NBER08/DIY-Startracker/hardware/CAD/README.md

# 3D CAD design
All 3D design for this project were done in Onshape.
[Project link](https://cad.onshape.com/documents/59d2a65c75123b6fec6ec18b/w/6b35aeebfd23d6bcbcd6099d/e/87f6b82d51a6b9adfaf05478)
