NBER08/DIY-Startracker/firmware/Startracker_draft/src/sensors/gps.h

#pragma once
#include <stdbool.h>

// This is everything the rest of the code needs to know about GPS.
// It doesn't need to know HOW we get it — just what we get.

typedef struct {
    double lat;       // e.g. 46.07  (your latitude in degrees)
    double lon;       // e.g. 18.23  (your longitude in degrees)
    long   unix_sec;  // current UTC time as seconds since 1970
    int    satellites;
    bool   valid;     // false until we have a real fix
} GpsFix;

// Call once at startup
void gps_begin();

// Call anytime to get the latest data.
// Returns a GpsFix — check .valid before using it.
GpsFix gps_read();
