NBER08/DIY-Startracker/(commit log)

2026-03-11 Copied KiCAD project into hardware
    [Startracker.kicad_pcb, Startracker.kicad_sch, conn.kicad_sch, lora.kicad_sch, motor_driver.kicad_sch, obc.kicad_sch, ps.kicad_sch, sensors.kicad_sch]
2026-03-11 tested gitignore
    [Startracker.kicad_pcb, Startracker.kicad_sch, conn.kicad_sch, lora.kicad_sch, motor_driver.kicad_sch, obc.kicad_sch, ps.kicad_sch, sensors.kicad_sch]
2026-03-11 Revise README with updated schematic and design rules
    Updated the schematic structure and design rules sections, including new sheets and fabrication details.
2026-03-12 Added connection for external IMU to PCB
    [Startracker.kicad_sch, conn.kicad_sch, sensors.kicad_sch]
2026-03-12 Changed LoRa modul on PCB
    [lora.kicad_sch]
2026-03-12 Added I2C expander for motor drivers and changed LoRa module
    [Startracker.kicad_sch, lora.kicad_sch, motor_driver.kicad_sch, obc.kicad_sch]
2026-03-12 Started RF design for LoRa chip
    [lora.kicad_sch]
2026-03-13 Started shcematic design for LoRa chip
    [lora.kicad_sch]
2026-03-14 Finished schematic for LoRa, added BME280
    [Startracker.kicad_sch, conn.kicad_sch, lora.kicad_sch, motor_driver.kicad_sch, obc.kicad_sch, ps.kicad_sch, sensors.kicad_sch, usb.kicad_sch]
2026-03-14 Finished parts sourcing and added missing footprints
    [conn.kicad_sch, lora.kicad_sch, ps.kicad_sch]
2026-03-14 Rerouted changes on the PCB layout, Routed LoRa
    [Startracker.kicad_pcb, Startracker.kicad_sch, motor_driver.kicad_sch, obc.kicad_sch, sensors.kicad_sch]
2026-03-14 Completed placement of components on PCB
    [Startracker.kicad_pcb, sensors.kicad_sch]
2026-03-14 Finished routing and layout of PCB
    [Startracker.kicad_pcb, obc.kicad_sch, sensors.kicad_sch]
2026-03-16 correctedai code and started customizing
    [gps.cpp, imu.cpp, imu.h, main.cpp, motor.cpp]
2026-03-16 Added remaining sensors to firmware
2026-03-17 made test file for testing esp timer
2026-03-19 Removed on-PCB BNO085 and added VL53L4CD ToF sensor
    [sensors.kicad_sch]
2026-03-19 Routed VL53L4CD
    [Startracker.kicad_pcb, Startracker.kicad_sch, sensors.kicad_sch]
2026-03-19 Removed correction feature from firmware
    [imu.h, lora.cpp, lora.h, main.cpp, motor.cpp, motor.h]
2026-03-19 added external ToF instead of on-PCB
    [Startracker.kicad_pcb, Startracker.kicad_sch, obc.kicad_sch, sensors.kicad_sch]
2026-03-19 Added external QMC5883L instead of on-PCB IIS2MDCTR
    [Startracker.kicad_pcb, sensors.kicad_sch]
2026-03-28 Removed polar azimuth motor driver from pcb
    [Startracker-CuBottom.gbr, Startracker-CuIn1.gbr, Startracker-CuIn2.gbr, Startracker-CuTop.gbr, Startracker-EdgeCuts.gbr, Startracker-MaskBottom.gbr, Startracker-MaskTop.gbr, Startracker-NPTH.drl]
2026-04-02 Reorganized PCB files and made BNO085 breakout
    [Startracker-CuBottom.gbr, Startracker-CuIn1.gbr, Startracker-CuIn2.gbr, Startracker-CuTop.gbr, Startracker-EdgeCuts.gbr, Startracker-MaskBottom.gbr, Startracker-MaskTop.gbr, Startracker-NPTH.drl]
